joshbrew/HEGduino_V0/ppg2_1600.PNG

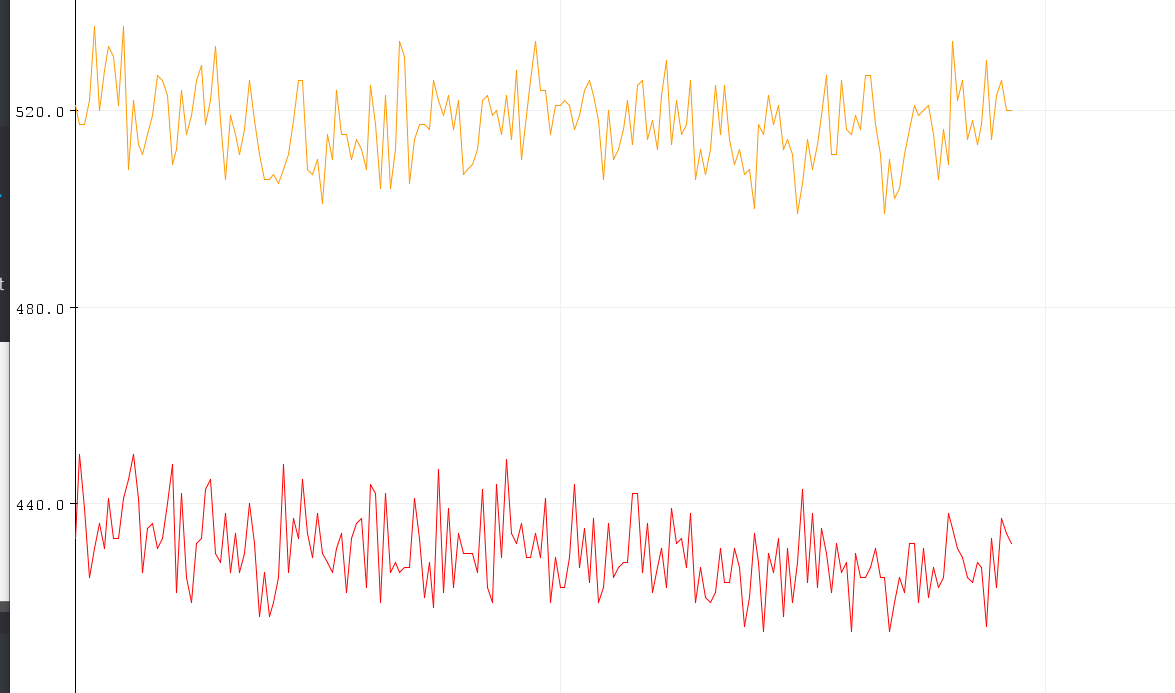
ppg2_1600.PNG
